JeffB-BE/ContinuityTester/KiCad/ContinuityTesterTHT/img/ContinuityTesterAssembly_(with_THT-PCB_v1~6).jpg

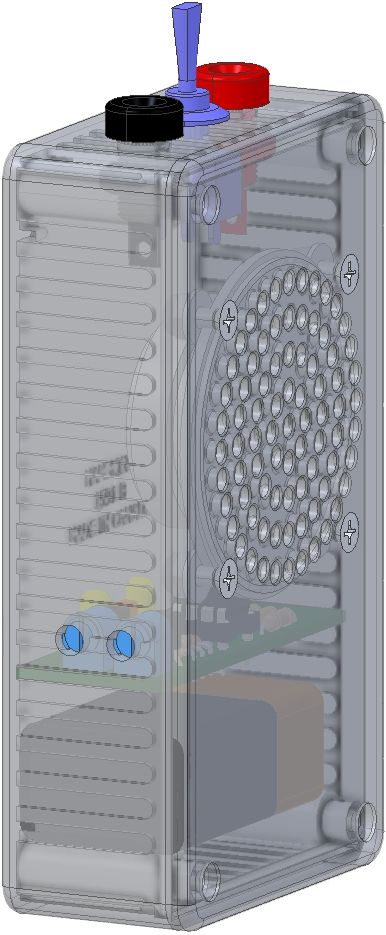
KiCad/ContinuityTesterTHT/img/ContinuityTesterAssembly_(with_THT-PCB_v1~6).jpg
