JeffB-BE/ContinuityTester/KiCad/ContinuityTesterTHT/img/ContinuityTester_THT-PCB_3D_Render.png

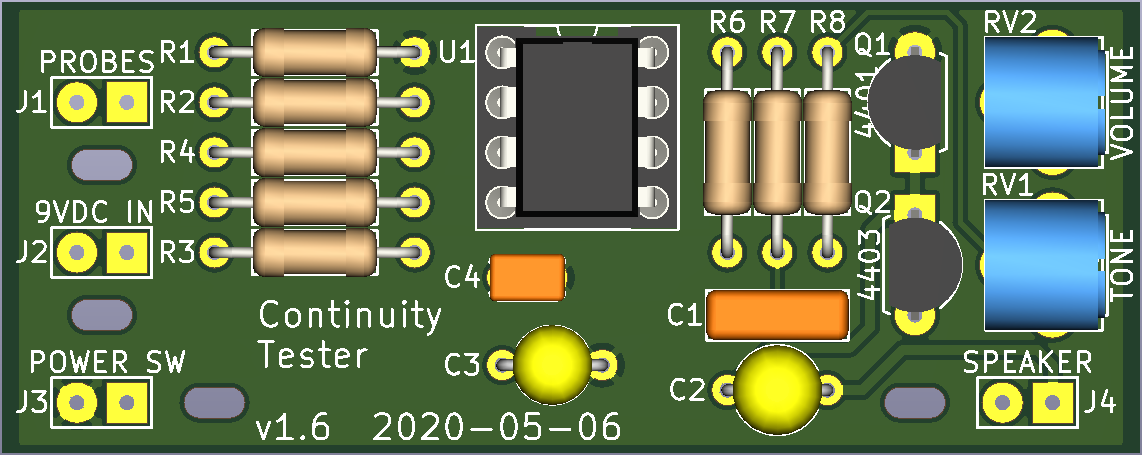
KiCad/ContinuityTesterTHT/img/ContinuityTester_THT-PCB_3D_Render.png
