JeffB-BE/ContinuityTester/KiCad/3D_Models/CAP_Tant_P200_d020_D180_H350.stp

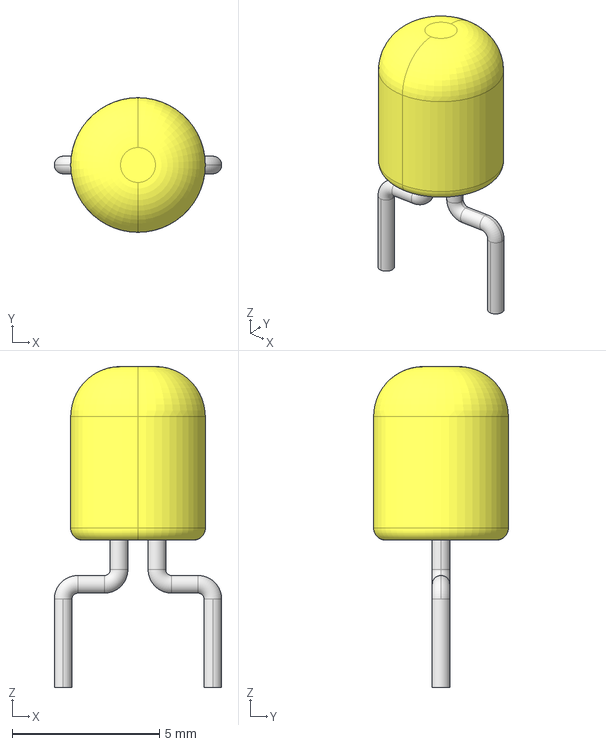
[picture p3: CAD file, 2020-05-09]
KiCad/3D_Models/CAP_Tant_P200_d020_D180_H350.stp
5.68 x 4.57 x 10.9 mm
