JeffB-BE/ContinuityTester/KiCad/3D_Models/CAP_Rect_P200_d020_L285_T100_H255.stp

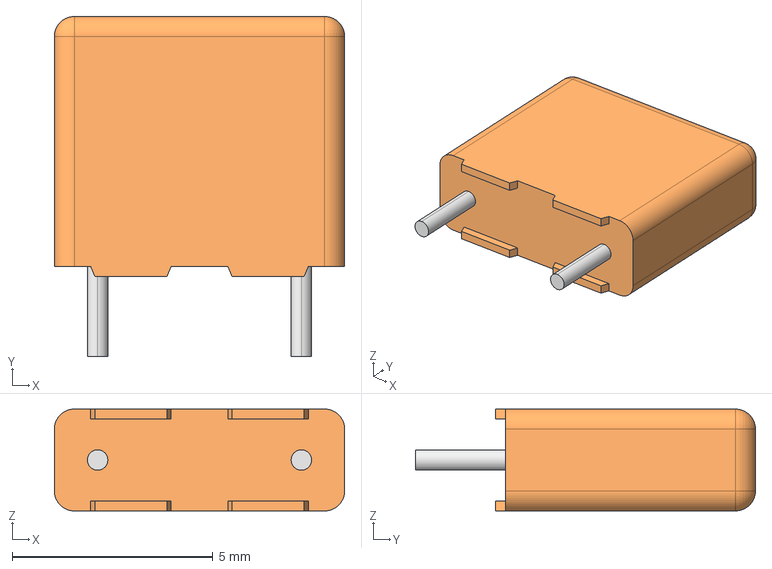
[picture p4: CAD file, 2020-05-09]
KiCad/3D_Models/CAP_Rect_P200_d020_L285_T100_H255.stp
7.24 x 8.48 x 2.54 mm
