JeffB-BE/ContinuityTester/KiCad/3D_Models/CAP_Tant_P200_d020_D160_H350.stp

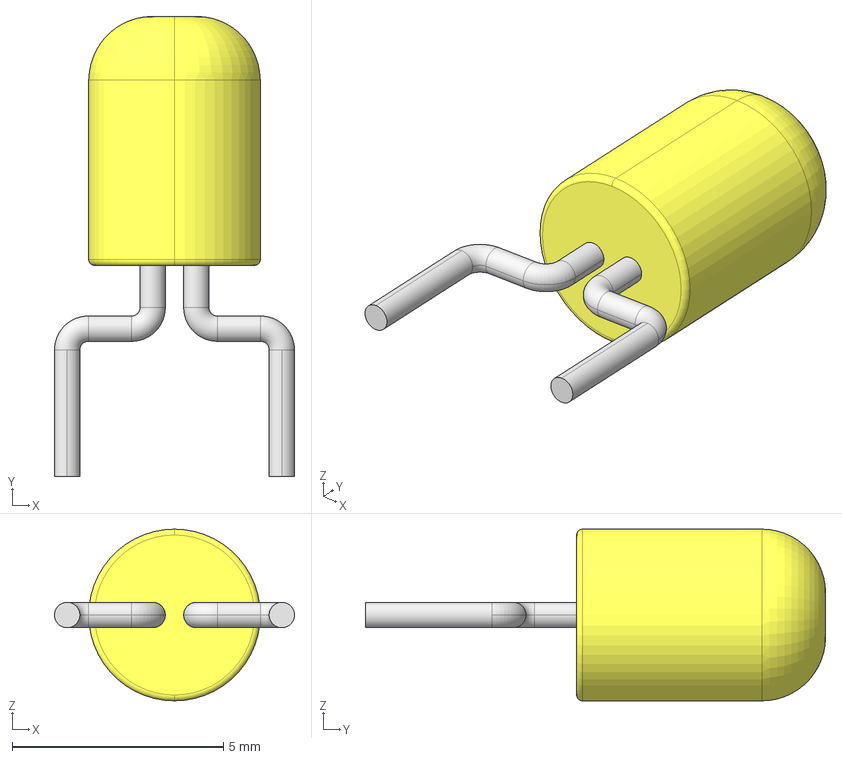
[picture p5: CAD file, 2020-05-09]
KiCad/3D_Models/CAP_Tant_P200_d020_D160_H350.stp
5.68 x 10.9 x 4.06 mm
