JeffB-BE/ContinuityTester/KiCad/3D_Models/Bourns 3329S SIMPLE (from dwg).stp

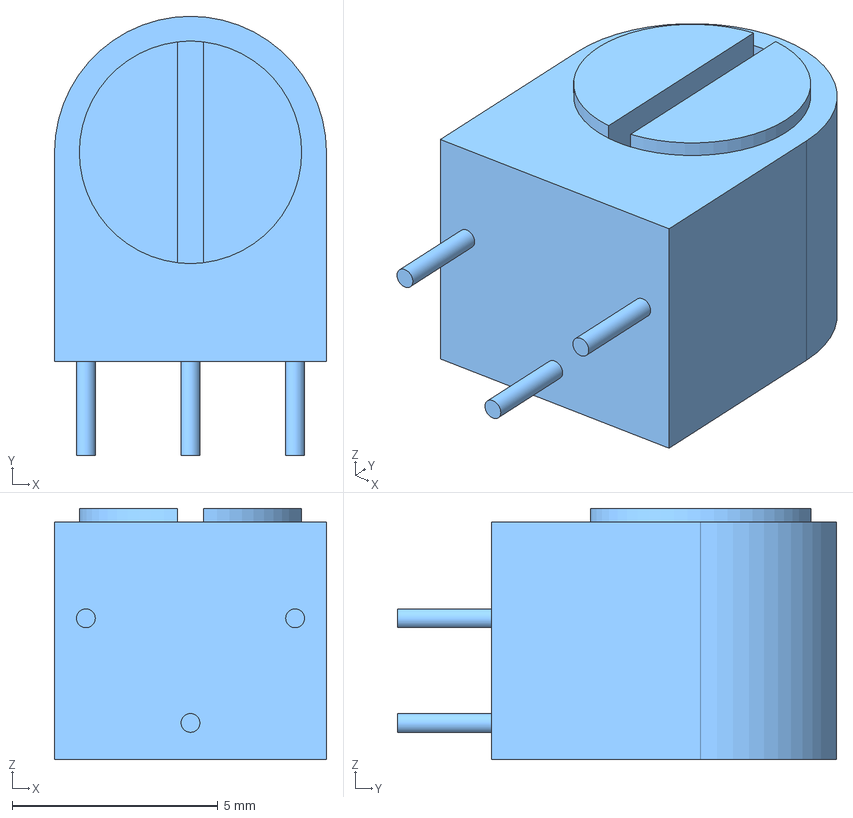
[picture p6: CAD file, 2020-05-09]
KiCad/3D_Models/Bourns 3329S SIMPLE (from dwg).stp
6.60 x 10.7 x 6.10 mm
