JeffB-BE/ContinuityTester/Mechanical/Continuity_Tester_Enclosure_Modifications_v1~1.pdf

# Continuity Tester Enclosure Modifocations (Hammond 1591BSGY)

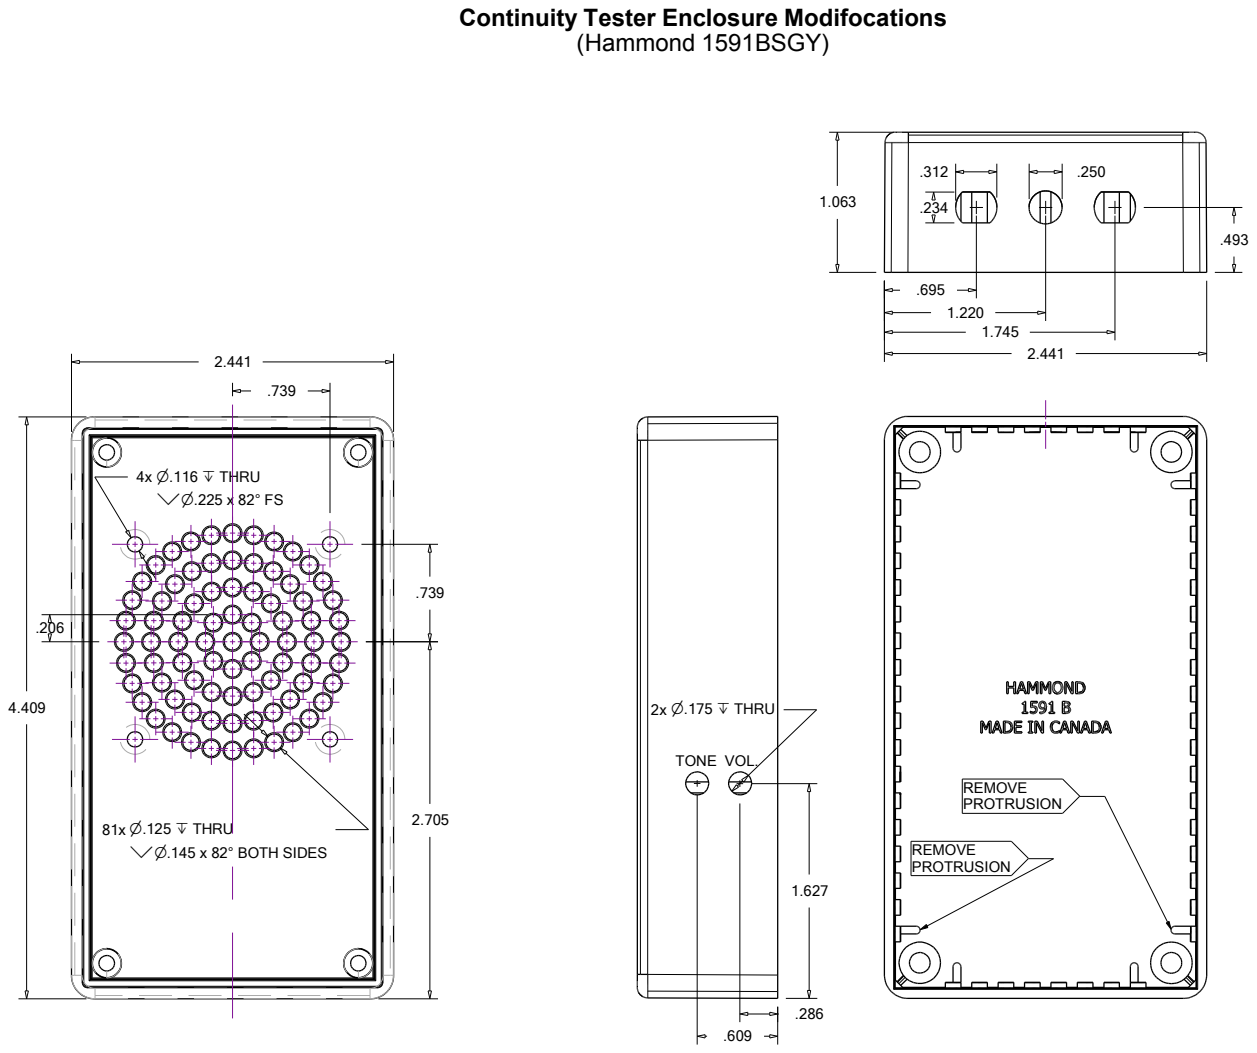
[picture p7: page 1]
BOTH SIDES; x THRU; REMOVE PROTRUSION; 2x n.175 x THRU; TONE VOL.
