JeffB-BE/ContinuityTester/KiCad/ContinuityTesterSMD/ContinuityTesterSMD.kicad_pcb

## KiCad design KiCad/ContinuityTesterSMD/ContinuityTesterSMD.kicad_pcb (2020-05-09)

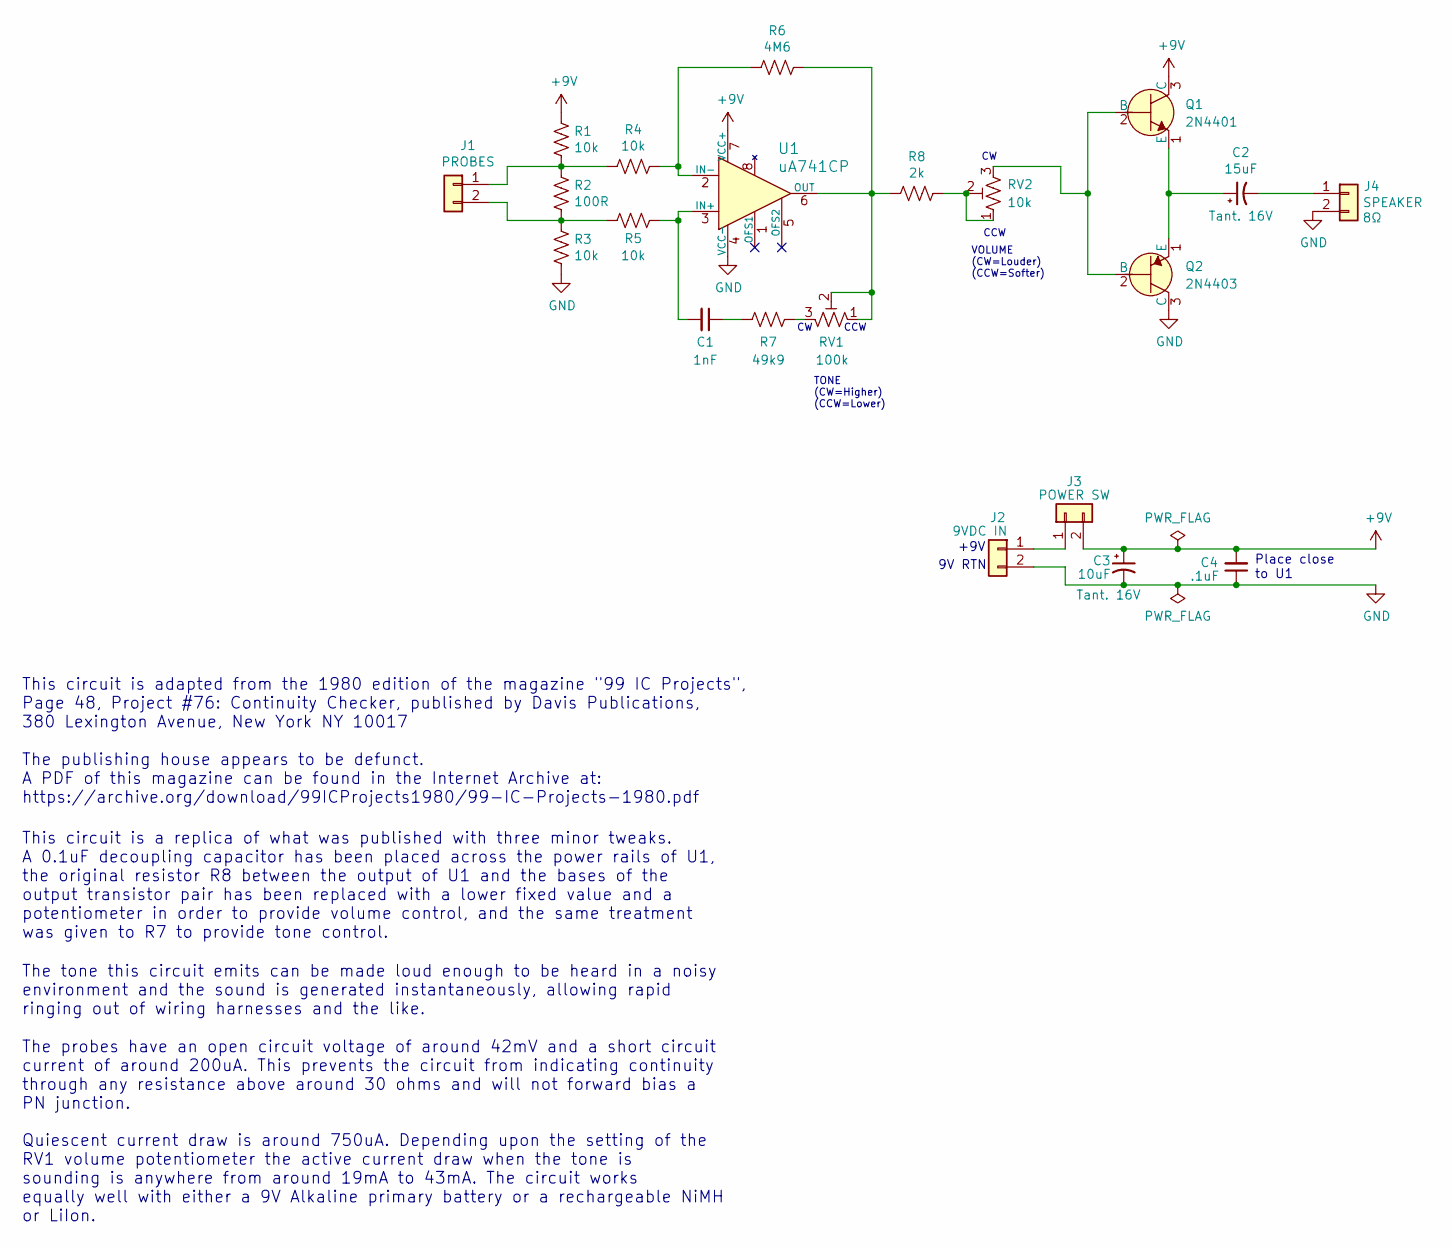
[picture p8: schematic ContinuityTesterSMD.sch, Continuity Tester (SMD)]

Parts:
C1: 1nF; C_0805_2012Metric
C2: 15uF; CP_EIA-6032-28_Kemet-C
C3: 10uF; CP_EIA-3216-18_Kemet-A
C4: .1uF; C_0805_2012Metric
J1: PROBES; SolderWirePad_1x02_Pitch100mil_Drill30mil
J2: 9VDC IN; SolderWirePad_1x02_Pitch100mil_Drill30mil
J3: POWER SW; SolderWirePad_1x02_Pitch100mil_Drill30mil
J4: SPEAKER; SolderWirePad_1x02_Pitch100mil_Drill30mil
Q1: 2N4401; SOT-23; MPN 2N4401BU; Digi-Key_PN 2N4401-ND
Q2: 2N4403; SOT-23; MPN 2N4403BU; Digi-Key_PN 2N4403-ND
R1, R3, R4, R5: 10k; R_0805_2012Metric
R2: 100R; R_0805_2012Metric
R6: 4M6; R_0805_2012Metric
R7: 49k9; R_0805_2012Metric
R8: 2k; R_0805_2012Metric
RV1: 100k; Bourns_3329S_Vertical
RV2: 10k; Bourns_3329S_Vertical
U1: uA741CP; SOIC-8_3.9x4.9mm_P1.27mm

Connections:
+9V: C3.1, C4.2, J3.2, Q1.3 (C), R1.1, U1.7 (VCC+)
GND: C3.2, C4.1, J2.2, J4.2, Q2.3 (C), R3.2, U1.4 (VCC-)
unnamed: C1.1, R7.2
unnamed: C1.2, R5.1, U1.3 (IN+)
unnamed: C2.1, Q1.1 (E), Q2.1 (E)
unnamed: C2.2, J4.1
unnamed: J1.1, R1.2, R2.1, R4.2
unnamed: J1.2, R2.2, R3.1, R5.2
unnamed: J2.1, J3.1
unnamed: Q1.2 (B), Q2.2 (B), RV2.3
unnamed: R4.1, R6.2, U1.2 (IN-)
unnamed: R6.1, R8.2, RV1.1, RV1.2, U1.6 (OUT)
unnamed: R7.1, RV1.3
unnamed: R8.1, RV2.1, RV2.2

Notes on the sheet:
This circuit is adapted from the 1980 edition of the magazine "99 IC Projects", Page 48, Project #76: Continuity Checker, published by Davis Publications, 380 Lexington Avenue, New York NY 10017 The publishing house appears to be defunct. A PDF of this magazine can be found in the Internet Archive 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
Place close to U1
+9V
9V RTN
The probes have an open circuit voltage of around 42mV and a short circuit current of around 200uA. This prevents the circuit from indicating continuity through any resistance above around 30 ohms and will not forward bias a PN junction.
The tone this circuit emits can be made loud enough to be heard in a noisy environment and the sound is generated instantaneously, allowing rapid ringing out of wiring harnesses and the like.
Quiescent current draw is around 750uA. Depending upon the setting of the RV1 volume potentiometer the active current draw when the tone is sounding is anywhere from around 19mA to 43mA. The circuit works equally well with either a 9V Alkaline primary battery or a rechargeable NiMH or LiIon.
CCW
This circuit is a replica of what was published with three minor tweaks. A 0.1uF decoupling capacitor has been placed across the power rails of U1, the original resistor R8 between the output of U1 and the bases of the output transistor pair has been replaced with a lower fixed value and a potentio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
TONE (CW=Higher) (CCW=Lower)
VOLUME (CW=Louder) (CCW=Softer)

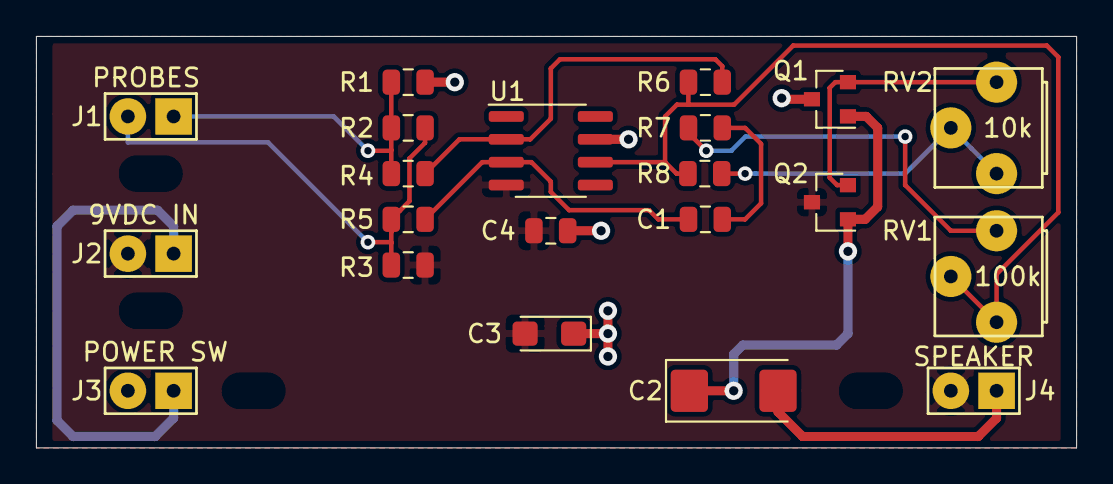
[picture p9: board ContinuityTesterSMD.kicad_pcb from above]

Board: 2 copper layers, 57.8 x 22.9 mm, 21 parts (0 on the bottom side), 14 nets.
