JeffB-BE/ContinuityTester/KiCad/ContinuityTesterSMD/img/ContinuityTesterSMD_PCB_v1~1_3D_Render.png

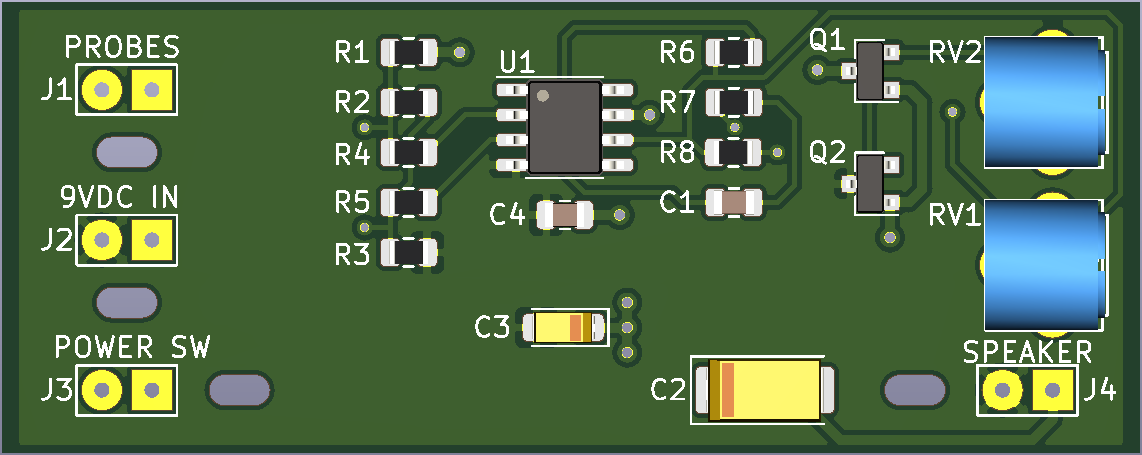
KiCad/ContinuityTesterSMD/img/ContinuityTesterSMD_PCB_v1~1_3D_Render.png
