JeffB-BE/ContinuityTester/KiCad/ContinuityTesterSMD/img/ContinuityTesterSMD_PCB_v1~1_Front.png

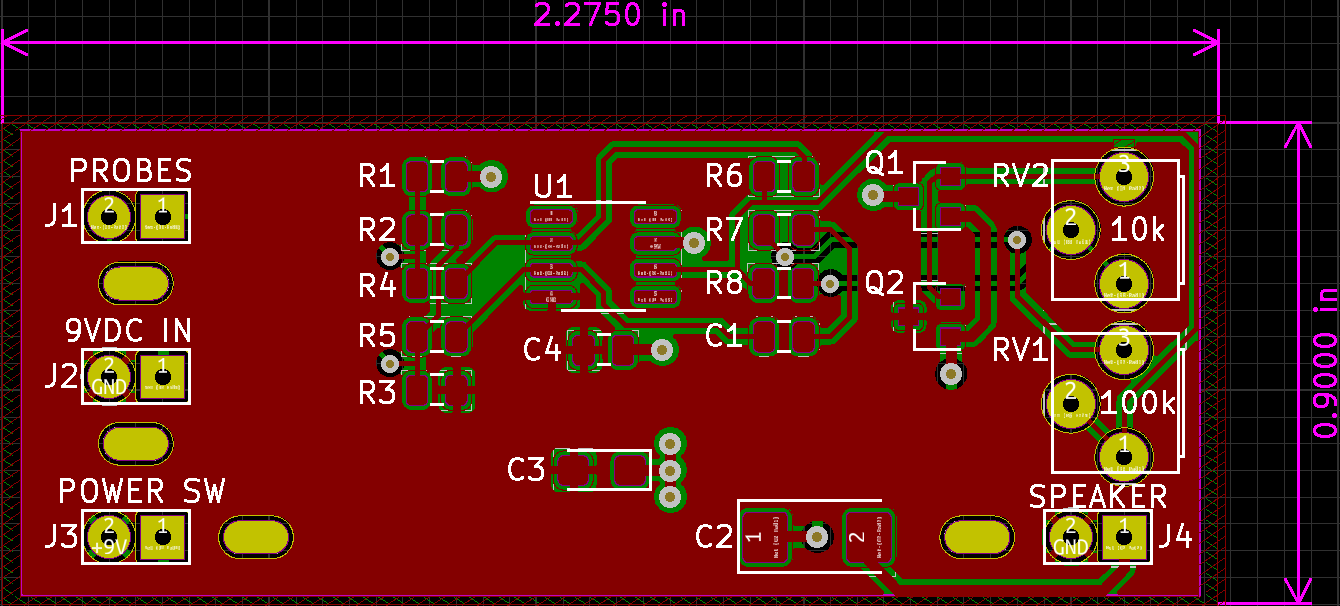
KiCad/ContinuityTesterSMD/img/ContinuityTesterSMD_PCB_v1~1_Front.png
