JeffB-BE/ContinuityTester/KiCad/ContinuityTesterSMD/img/ContinuityTesterSMD_PCB_v1~1_Rear.png

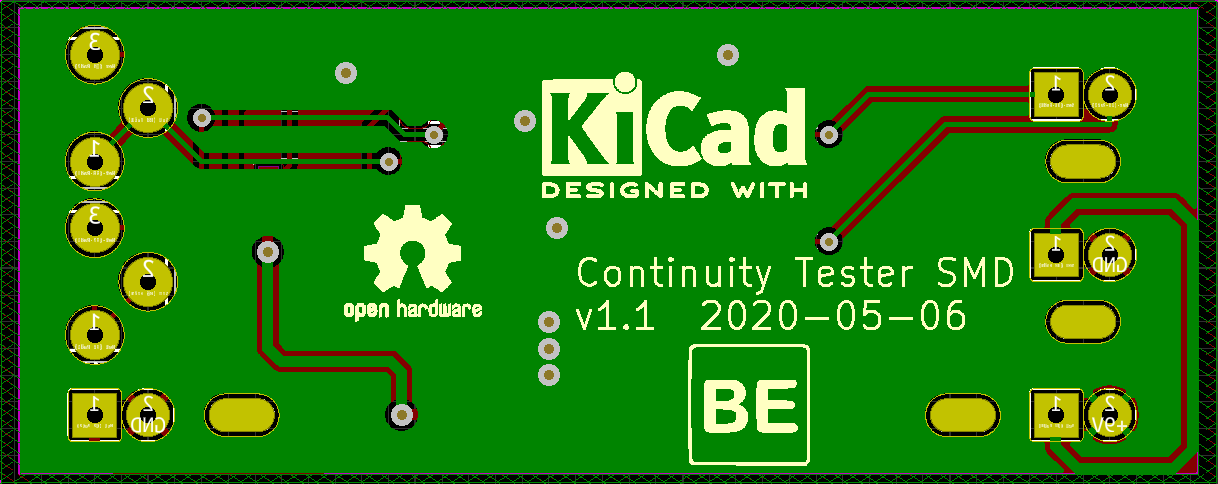
KiCad/ContinuityTesterSMD/img/ContinuityTesterSMD_PCB_v1~1_Rear.png
