JeffB-BE/ContinuityTester/KiCad/ContinuityTesterTHT/img/ContinuityTester_THT-PCB_Front.png

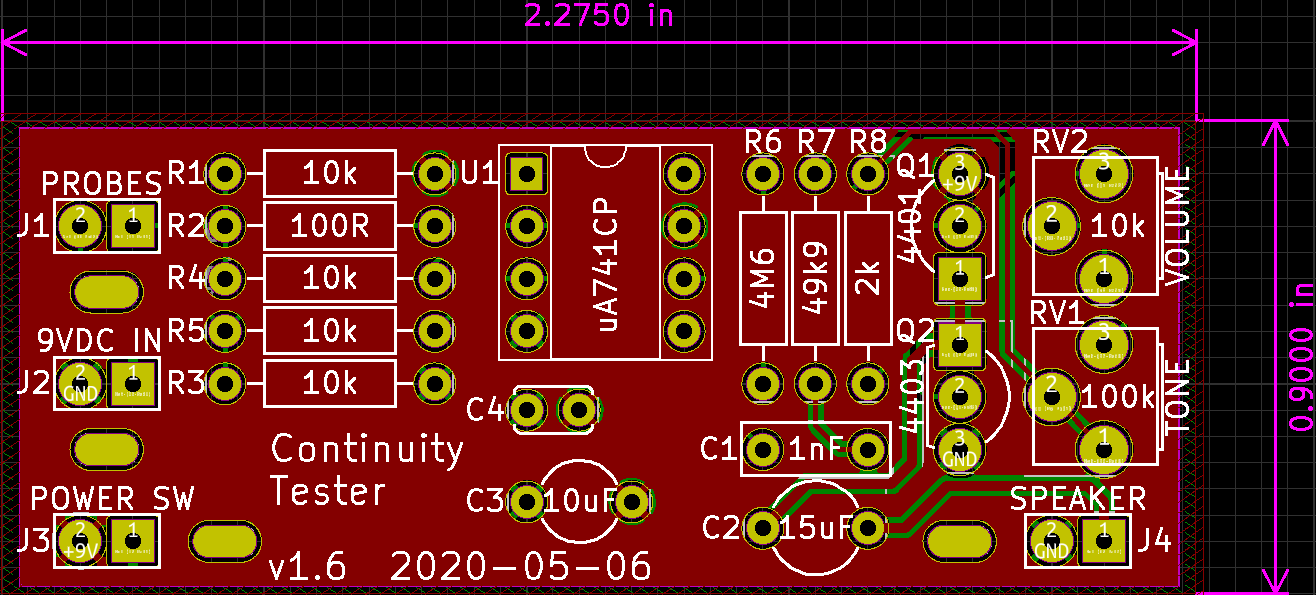
KiCad/ContinuityTesterTHT/img/ContinuityTester_THT-PCB_Front.png
