JeffB-BE/ContinuityTester/KiCad/ContinuityTesterTHT/img/ContinuityTester_THT-PCB_Rear.png

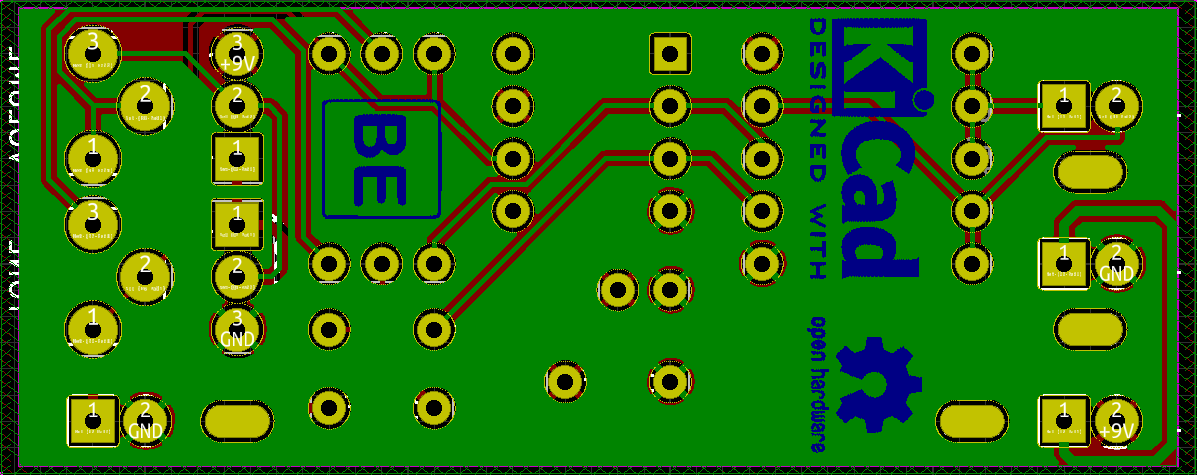
KiCad/ContinuityTesterTHT/img/ContinuityTester_THT-PCB_Rear.png
