JeffB-BE/ContinuityTester/Testing/SSBB_02-07-10-12k-Ohm_Composite.png

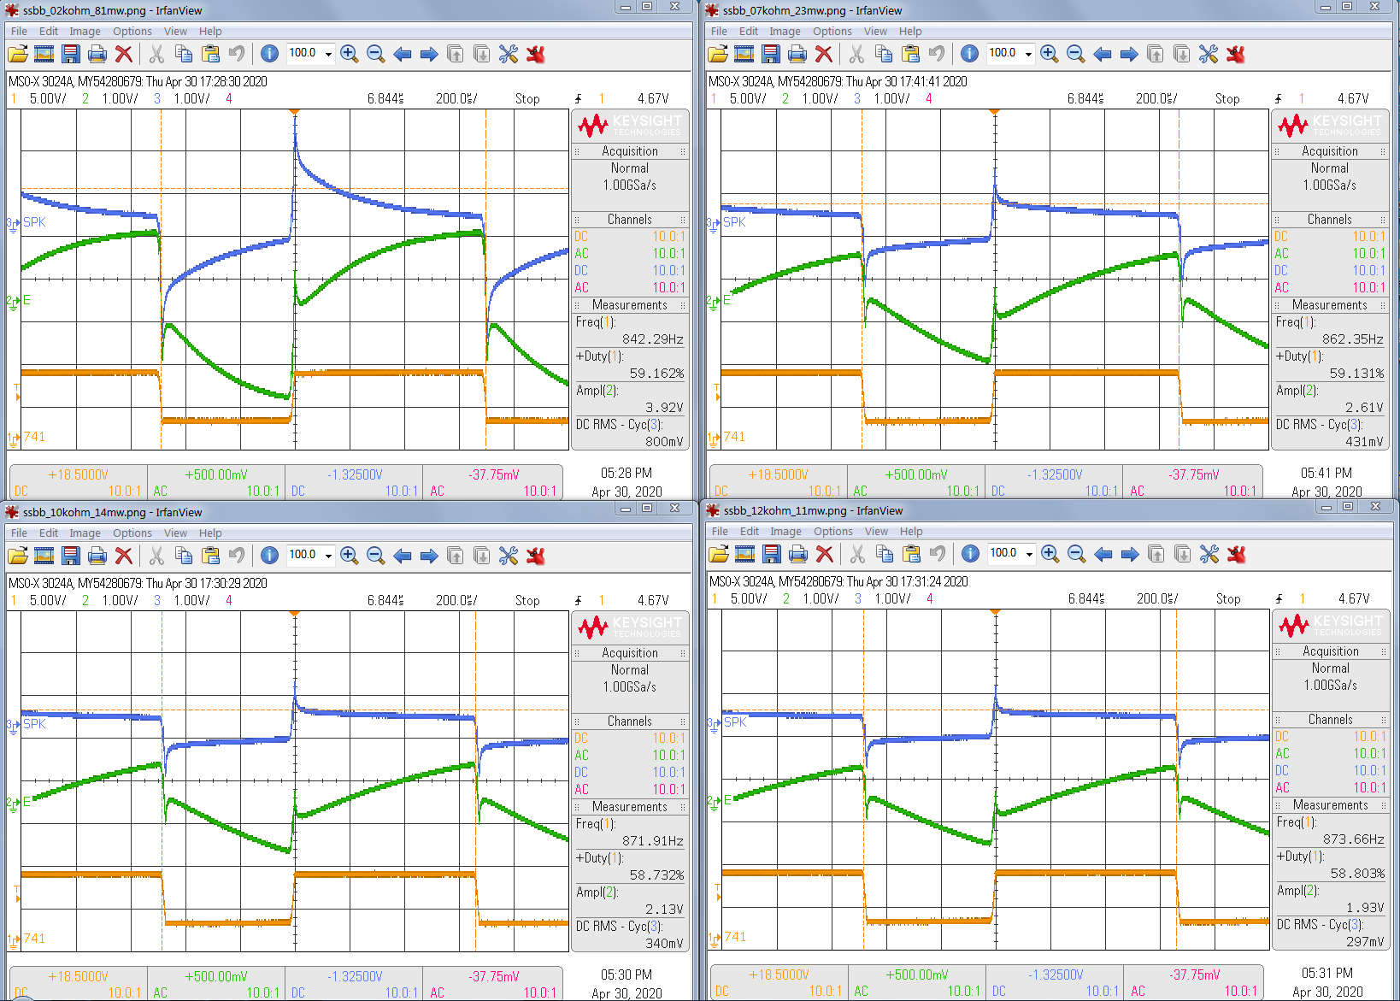
Testing/SSBB_02-07-10-12k-Ohm_Composite.png
