JeffB-BE/ContinuityTester/Testing/SSBB_02kOhm_81mw_42mA.png

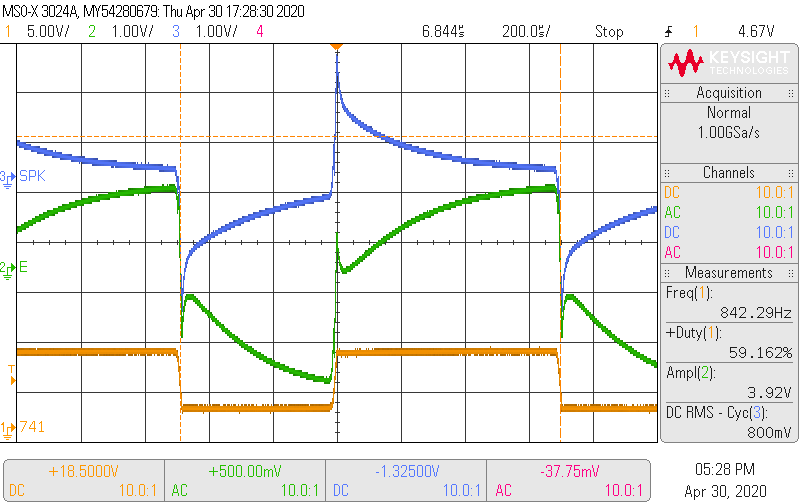
Testing/SSBB_02kOhm_81mw_42mA.png
