JeffB-BE/ContinuityTester/Testing/SSBB_10kOhm_14mw_21mA.png

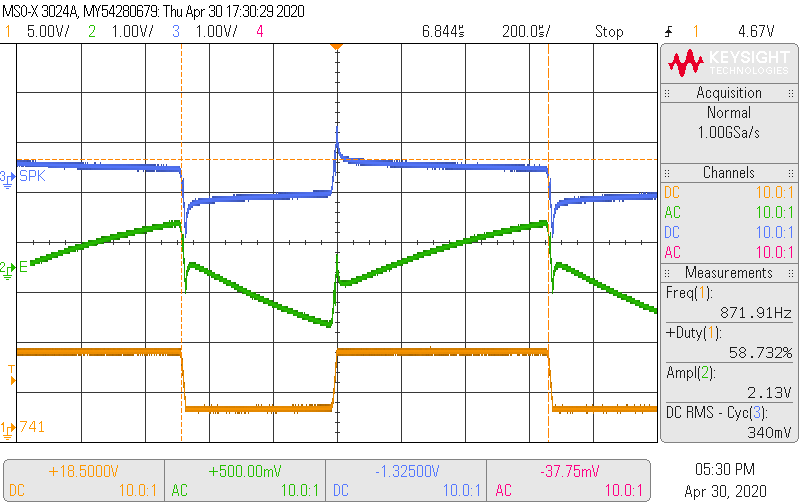
Testing/SSBB_10kOhm_14mw_21mA.png
