JeffB-BE/ContinuityTester/Testing/SSBB_(original)_741+spkr.png

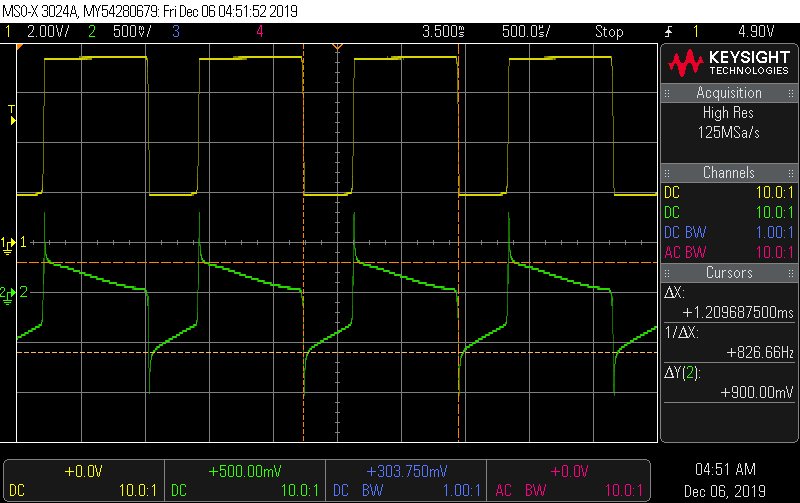
Testing/SSBB_(original)_741+spkr.png
