JeffB-BE/ContinuityTester/(commit log)

2020-05-09 Initial project upload
    [ContinuityTesterSMD.kicad_pcb, ContinuityTesterSMD.sch, ContinuityTesterTHT.kicad_pcb, ContinuityTesterTHT.sch]
2020-05-09 Added custom 3D models to repository
    [Bourns 3329S SIMPLE (from dwg).stp, CAP_Rect_P200_d020_L285_T100_H255.stp, CAP_Tant_P200_d020_D160_H350.stp, CAP_Tant_P200_d020_D180_H350.stp]
